aneesharnavch/doom_business_card/Assets/BACK_DOOM_BUSINESS_CARD.png

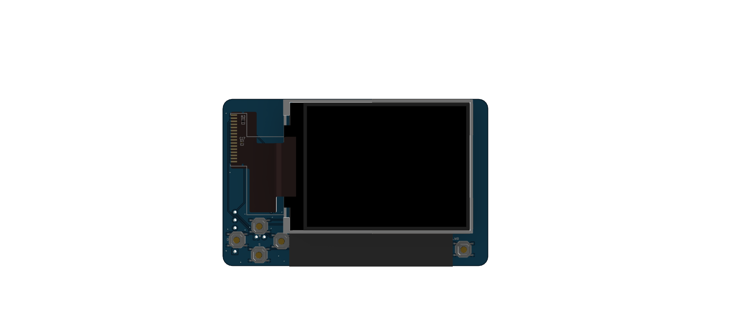
Assets/BACK_DOOM_BUSINESS_CARD.png
