aneesharnavch/doom_business_card/Assets/FRONT_DOOM_BUSINESS_CARD.png

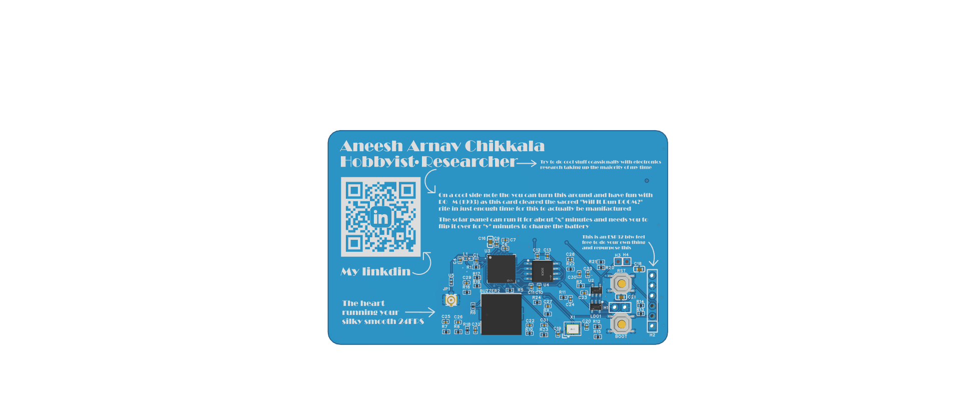
Assets/FRONT_DOOM_BUSINESS_CARD.png
