aneesharnavch/doom_business_card/Zine_buisniess_card.pdf

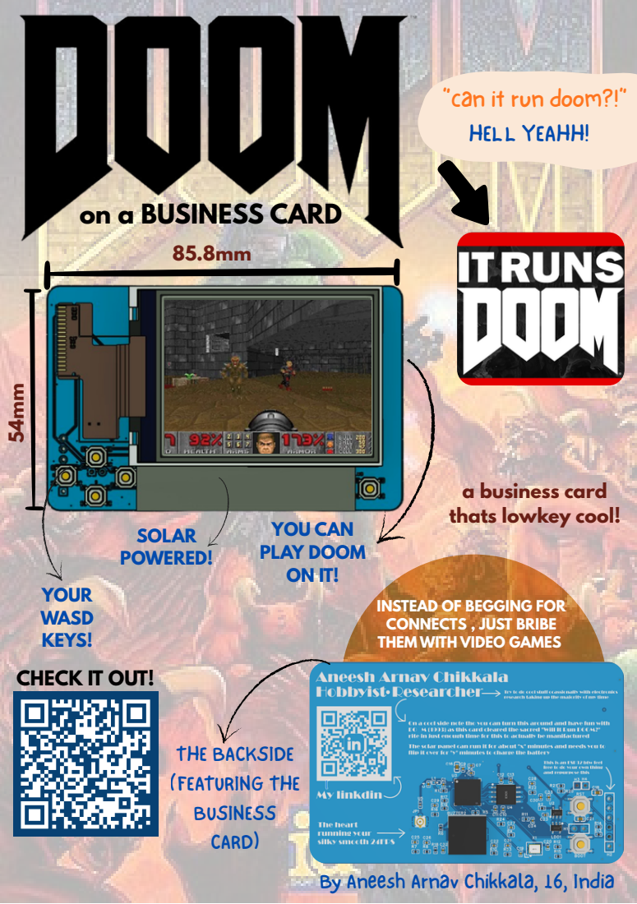
[picture p5: page 1]
YOU CAN PLAY DOOM ON IT!; SOLAR POWERED!; HELL YEAHH!

can it run doom?!”

on a BUSINESS CARD

a business card
thats lowkey cool!

YOUR
WASD
KEYS!
CHECK IT OUT!

INSTEAD OF BEGGING FOR
CONNECTS , JUST BRIBE
THEMWITH VIDEO GAMES

THE BACKSIDE
(FEATURING THE
BUSINESS
CARD)
By Aneesh Arnav Chikkala, 16, India
