aneesharnavch/doom_business_card/(list of files, drawings)

Other design files:
PCB_files/Source_Doom_Bcard.epro
