aneesharnavch/doom_business_card/(commit log)

2026-06-19 Add DOOM business card project: firmware, PCB/Gerber files, CAD, BOM, and README
    - ESP32-S3 doomgeneric/espDOOM firmware (firmware/)
    - Gerbers, pick-and-place, and EasyEDA source (PCB_files/)
    - Fusion 360 CAD + STEP export and board renders (CAD_Files/)
    - BOM and reworked README with schematic/PCB images in Assets/
    [BOM_doom_bcard.csv, PickAndPlace_Doom_Bcard.xlsx, Source_Doom_Bcard.epro, partitions.csv]
2026-06-20 Revise BOM in README with correct supplier details
    Updated the bill of materials (BOM) to correct manufacturer names and links.
