aneesharnavch/doom_business_card/(notices)

Notices in the files:
firmware/src/doom/r_plane.c:
modify it under the terms of the GNU General Public License
